jestemboski999/PiLPR/hardware/README.md

# Uchwyty do druku 3D

| Plik | Co to jest | Wymiary |
|---|---|---|
| `mocowanie_raspberry_v3.3mf`, `.stl` | uchwyt Raspberry Pi 5, wersja 3 | 44 × 86 × 70 mm |
| `mocowanie_kamery_imx708.3mf` | mocowanie kamery Arducam IMX708 | 32 × 33 × 10 mm |
| `mocowanie_tablicy.3mf` | mocowanie przy tablicy rejestracyjnej | 42 × 50 × 15 mm |

Projekty powstały w SolidWorks, pliki 3MF są gotowe do slicera.
