jestemboski999/PiLPR/docs/images/www_telefon.png

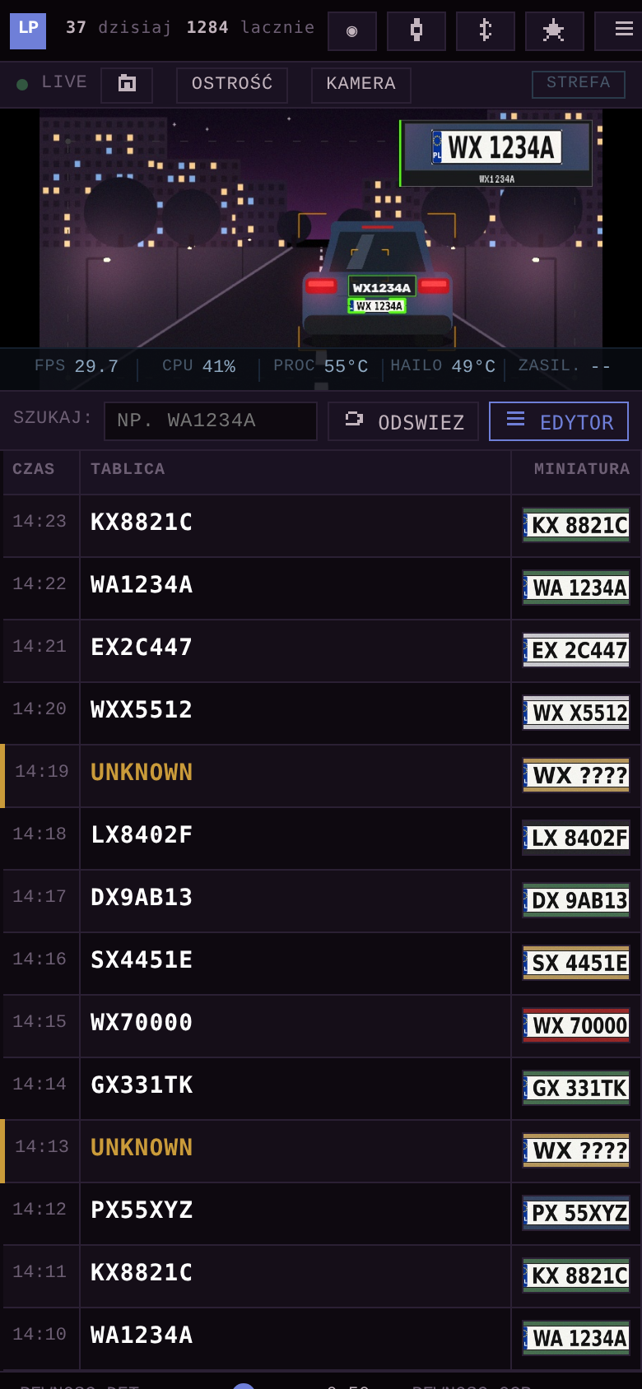
docs/images/www_telefon.png
