jestemboski999/PiLPR/hardware/mocowanie_raspberry_v3.3mf

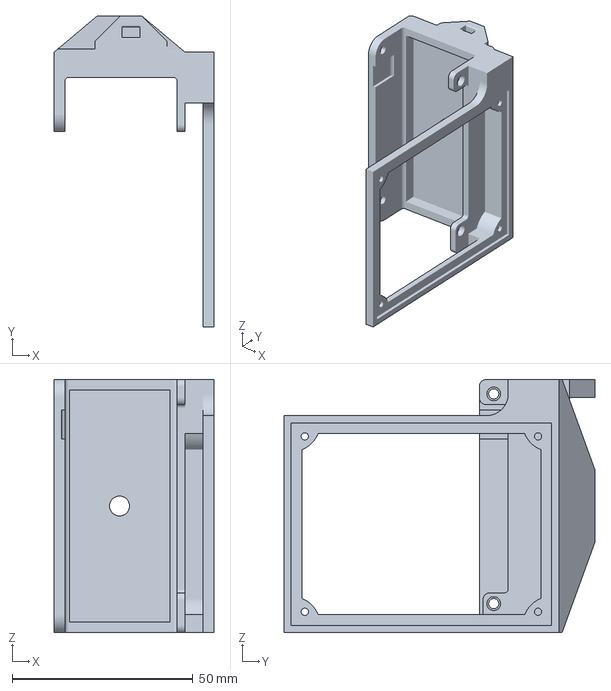
[picture p15: CAD file, 2026-10-27]
hardware/mocowanie_raspberry_v3.3mf
44.2 x 86.0 x 70.0 mm
