jestemboski999/PiLPR/hardware/mocowanie_tablicy.3mf

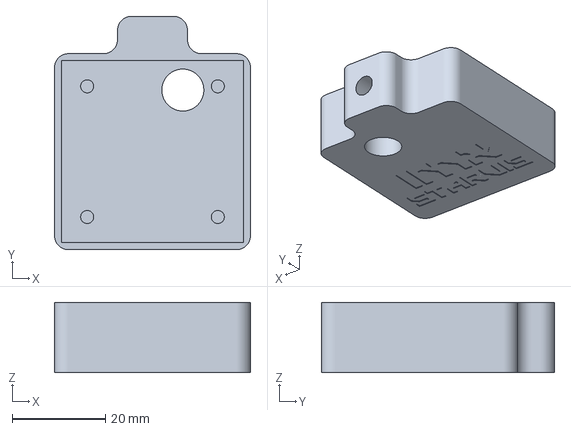
[picture p16: CAD file, 2026-10-27]
hardware/mocowanie_tablicy.3mf
42.0 x 50.0 x 15.0 mm
