jestemboski999/PiLPR/hardware/mocowanie_kamery_imx708.3mf

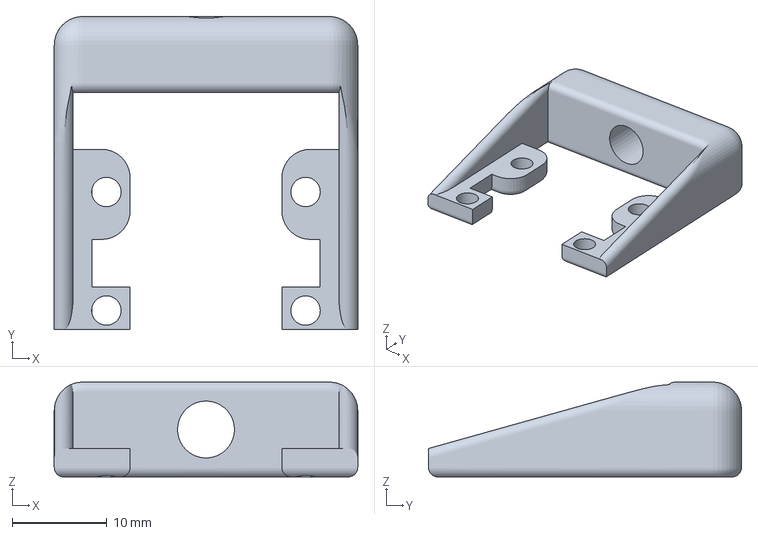
[picture p17: CAD file, 2026-10-27]
hardware/mocowanie_kamery_imx708.3mf
32.0 x 33.0 x 10.0 mm
