jestemboski999/PiLPR/(list of files, cad)

Other CAD files:
hardware/mocowanie_raspberry_v3.stl
